tatsujin16/Intelligent-Robot-Contest/1st_poster.pdf

# ロボット設計製作論実習4

# 知能ロボコン用機体の開発・回路設計

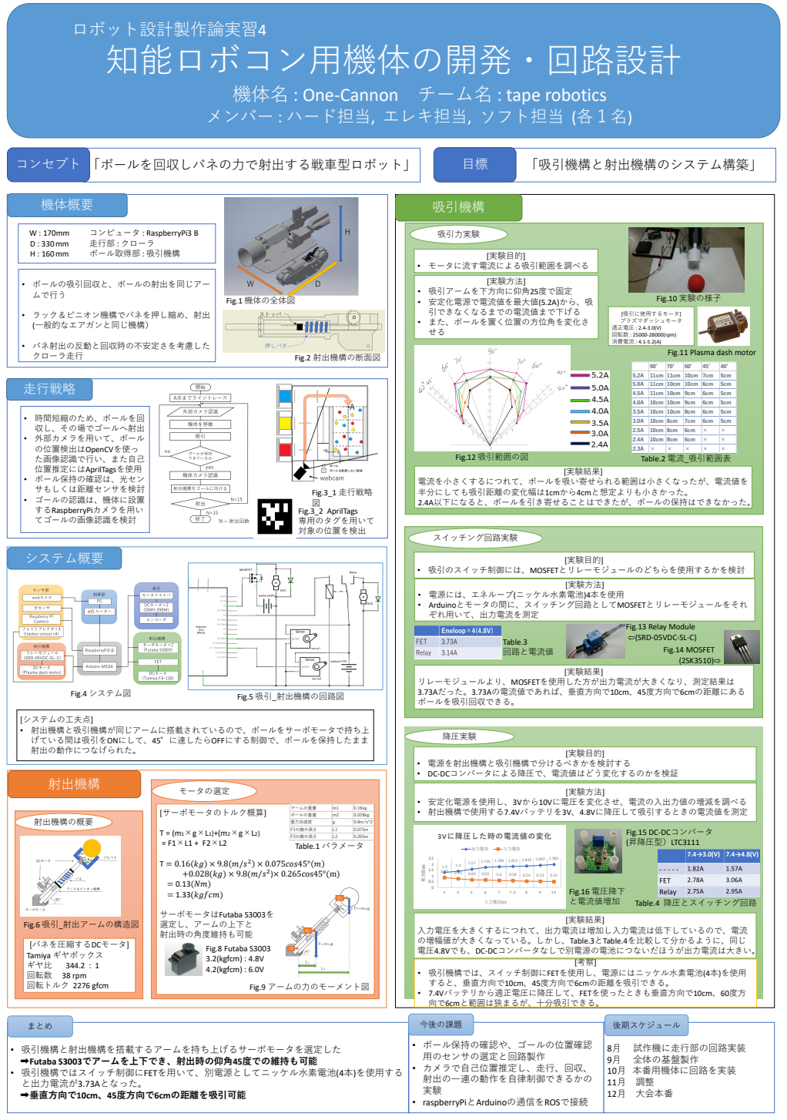
[picture p1: page 1]
機体概要; システム概要; 射出機構; 吸引機構; • 吸引機構と射出機構を搭載するアームを持ち上げるサーボモータを選定した ➡Futaba S3003でアームを上下でき、射出時の仰角45度での維持も可能 • 吸引機構ではスイッチ制御にFETを用いて、別電源としてニッケル水素電池(4本)を使用する と出力電流が3.73Aとなった。 ➡垂直方向で10cm、45度方向で6cmの距離を吸引可能; 試作機に走行部の回路実装; 全体の基盤製作; 10月 本番用機体に回路を実装 11月 調整 12月 大会本番; まとめ; 今後の課題; 後期スケジュール; コンセプト 「ボールを回収しバネの力で射出する戦車型ロボット」; 「吸引機構と射出機構のシステム構築」; 走行戦略; • ボールの吸引回収と、ボールの射出を同じアー ムで行う; • バネ射出の反動と回収時の不安定さを考慮した クローラ走行; モータの選定; 吸引力実験; [サーボモータのトルク概算]; 2 × 0.075cos45° m +0.028(kg) × 9.8(m/s; )× 0.265cos45°(m)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

機体名 : One-Cannon チーム名 : tape robotics
メンバー : ハード担当, エレキ担当, ソフト担当 (各１名)

• ラック＆ピニオン機構でバネを押し縮め、射出
(一般的なエアガンと同じ機構）

Fig.11 Plasma dash motor

5.2A | 11cm | 11cm | 10cm | 7cm | 5cm
5.0A | 11cm | 10cm | 10cm | 6cm | 5cm
4.5A | 11cm | 10cm | 9cm | 6cm | 5cm
4.0A | 10cm | 10cm | 9cm | 6cm | 5cm
3.5A | 10cm | 10cm | 8cm | 6cm | 5cm
3.0A | 10cm | 8cm | 7cm | 6cm | 5cm
2.5A | 10cm | 8cm | 6cm | × | ×
2.4A | 10cm | 8cm | 6cm | × | ×
2.3A | × | × | × | × | ×

電流を小さくするにつれて、ボールを吸い寄せられる範囲は小さくなったが、電流値を
半分にしても吸引距離の変化幅は1cmから4cmと想定よりも小さかった。
2.4A以下になると、ボールを引き寄せることはできたが、ボールの保持はできなかった。

• 電源には、エネループ(ニッケル水素電池)4本を使用
• Arduinoとモータの間に、スイッチング回路としてMOSFETとリレーモジュールをそれ
ぞれ用いて、出力電流を測定

Fig.13 Relay Module
⇦(SRD-05VDC-SL-C)

[システムの工夫点]
• 射出機構と吸引機構が同じアームに搭載されているので、ボールをサーボモータで持ち上
げている間は吸引をONにして、45°に達したらOFFにする制御で、ボールを保持したまま
射出の動作につなげられた。

• 電源を射出機構と吸引機構で分けるべきかを検討する
• DC-DCコンバータによる降圧で、電流値はどう変化するのかを検証

アームの重量 | m1 | 0.16kg
ボールの重量 | m2 | 0.028kg
重力加速度 | g | 9.8m/s^2
F1の腕の長さ | L1 | 0.075m
F2の腕の長さ | L2 | 0.265m

Fig.15 DC-DCコンバータ
(昇降圧型）LTC3111

入力電圧を大きくするにつれて、出力電流は増加し入力電流は低下しているので、電流
の増幅値が大きくなっている。しかし、Table.3とTable.4を比較して分かるように、同じ
電圧4.8Vでも、DC-DCコンバータなしで別電源の電池につないだほうが出力電流は大きい。

• 吸引機構では、スイッチ制御にFETを使用し、電源にはニッケル水素電池(4本)を使用
すると、垂直方向で10cm、45度方向で6cmの距離を吸引できる。
• 7.4Vバッテリから適正電圧に降圧して、FETを使ったときも垂直方向で10cm、60度方
向で6cmと範囲は狭まるが、十分吸引できる。

• ボール保持の確認や、ゴールの位置確認
用のセンサの選定と回路製作
• カメラで自己位置推定し、走行、回収、
射出の一連の動作を自律制御できるかの
• raspberryPiとArduinoの通信をROSで接続
