tatsujin16/Intelligent-Robot-Contest/2nd_poster.pdf

# ロボット設計製作論実習5

# 知能ロボコン用機体の開発・回路設計

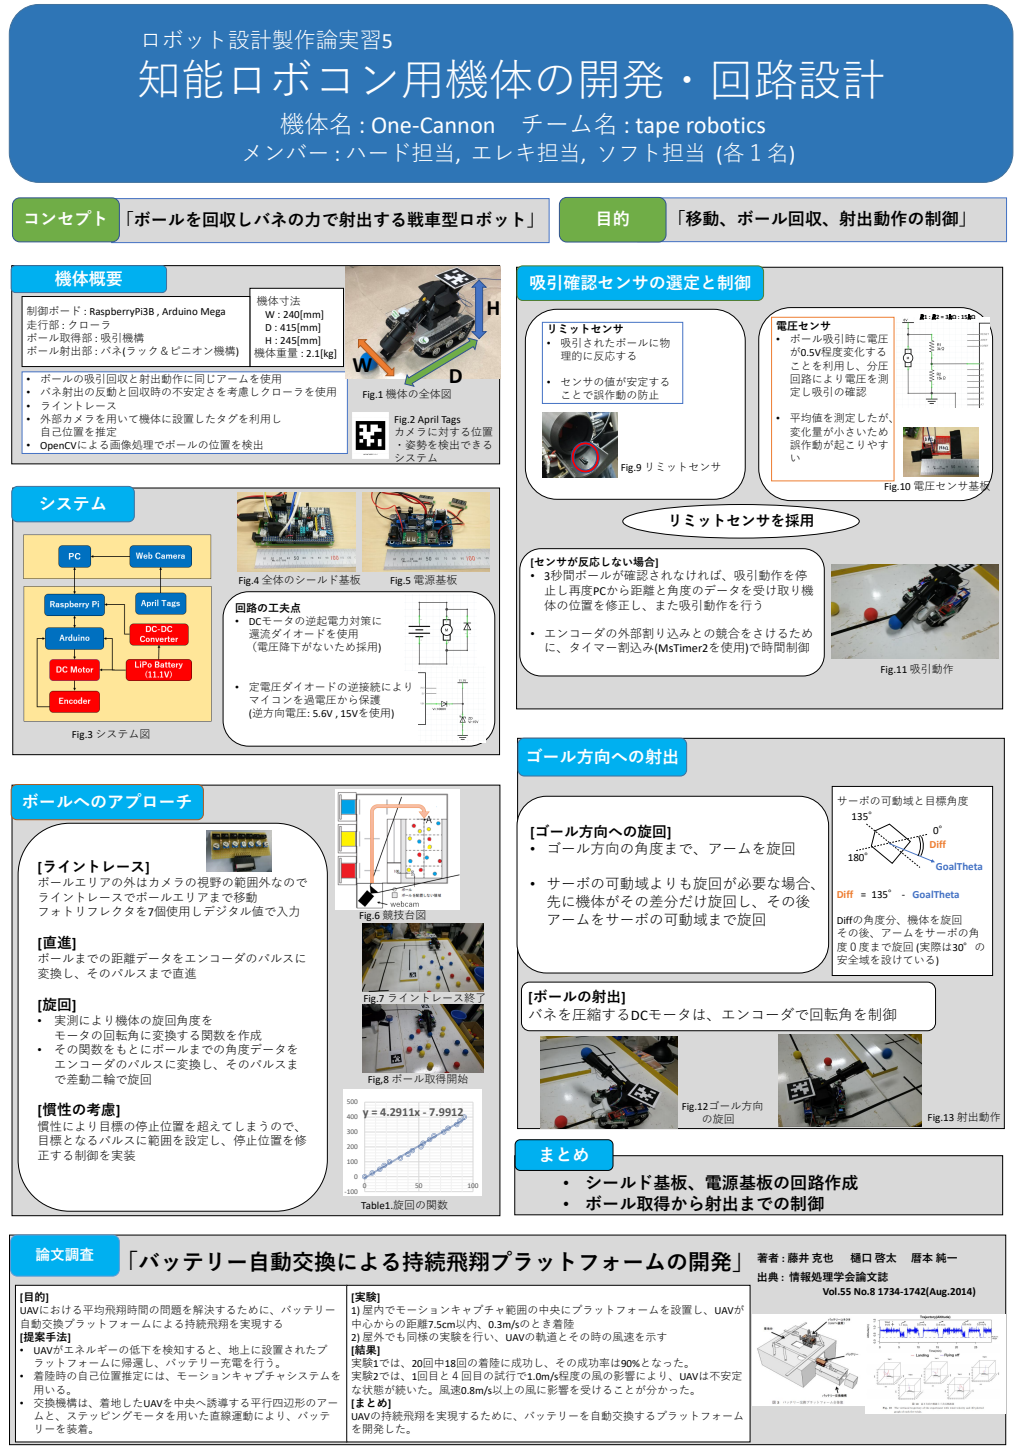
[picture p2: page 1]
[ライントレース] ボールエリアの外はカメラの視野の範囲外なので ライントレースでボールエリアまで移動 フォトリフレクタを7個使用しデジタル値で入力; [直進] ボールまでの距離データをエンコーダのパルスに 変換し、そのパルスまで直進; [旋回] • 実測により機体の旋回角度を モータの回転角に変換する関数を作成 • その関数をもとにボールまでの角度データを エンコーダのパルスに変換し、そのパルスま で差動二輪で旋回; [慣性の考慮] 慣性により目標の停止位置を超えてしまうので、 目標となるパルスに範囲を設定し、停止位置を修 正する制御を実装; • シールド基板、電源基板の回路作成 • ボール取得から射出までの制御; 機体概要; ボールへのアプローチ; 吸引確認センサの選定と制御; コンセプト 「ボールを回収しバネの力で射出する戦車型ロボット」; 「移動、ボール回収、射出動作の制御」; システム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

機体名 : One-Cannon チーム名 : tape robotics
メンバー : ハード担当, エレキ担当, ソフト担当 (各１名)

制御ボード : RaspberryPi3B , Arduino Mega
走行部 : クローラ
ボール取得部 : 吸引機構
ボール射出部 : バネ(ラック＆ピニオン機構)

Fig.2 April Tags
カメラに対する位置
・姿勢を検出できる
システム

Vol.55 No.8 1734-1742(Aug.2014)

UAVにおける平均飛翔時間の問題を解決するために、バッテリー
自動交換プラットフォームによる持続飛翔を実現する
[提案手法]
• UAVがエネルギーの低下を検知すると、地上に設置されたプ
ラットフォームに帰還し、バッテリー充電を行う。
• 着陸時の自己位置推定には、モーションキャプチャシステムを
用いる。
• 交換機構は、着地したUAVを中央へ誘導する平行四辺形のアー
ムと、ステッピングモータを用いた直線運動により、バッテ
リーを装着。
